ullnorse/ull-pocket/DATASHEETS.md

# Datasheets

Manufacturer datasheets are not stored in this repo. Download them from the links below. `datasheets/` is git-ignored for local copies.

| Ref | Part | LCSC | Datasheet |
|---|---|---|---|
| U1 | ESP32-C6-MINI-1-N4 module | C5736265 | [Espressif](https://www.espressif.com/sites/default/files/documentation/esp32-c6-mini-1_mini-1u_datasheet_en.pdf) |
| U1 | ESP32-C6 SoC | - | [Espressif](https://www.espressif.com/sites/default/files/documentation/esp32-c6_datasheet_en.pdf) |
| U2 | SHT40-AD1B | C2909890 | [Sensirion](https://sensirion.com/media/documents/33FD6951/67EB9032/HT_DS_Datasheet_SHT4x_5.pdf) |
| U3 | BMP580 | C22391138 | [Bosch](https://www.bosch-sensortec.com/media/boschsensortec/downloads/datasheets/bst-bmp580-ds004.pdf) |
| U4 | LIS2DW12TR | C189624 | [ST](https://www.st.com/resource/en/datasheet/lis2dw12.pdf) |
| U5 | MAX17048G+T10 | C2682616 | [Analog Devices](https://www.analog.com/media/en/technical-documentation/data-sheets/MAX17048-MAX17049.pdf) |
| U6 | BQ24073RGTR | C15220 | [TI](https://www.ti.com/lit/ds/symlink/bq24073.pdf) |
| U7 | RT9080-33GJ5 | C841192 | [Richtek](https://www.richtek.com/assets/product_file/RT9080/DS9080-05.pdf) |
| U8 | USBLC6-2SC6 (UMW) | C2687116 | [LCSC](https://www.lcsc.com/datasheet/C2687116.pdf) |
| J1 | TYPE-C-31-M-12 | C165948 | [LCSC](https://www.lcsc.com/datasheet/C165948.pdf) |
| J2 | 1.25-2PWB (PicoBlade series) | C2905009 | [LCSC](https://www.lcsc.com/datasheet/C2905009.pdf) |
| J3 | FPC-05FB-24PH20 | C2856831 | [LCSC](https://datasheet.lcsc.com/datasheet/pdf/e480b0871d0881a4ae70dd94a2979182.pdf?productCode=C2856831) (XUNPU drawing; page 1 shows pin 1 and the back-flip, dual-contact build) |
| Q1 | SI1308EDL | C469327 | [Vishay](https://www.vishay.com/docs/63399/si1308edl.pdf) |
| Q2 | AO3400A | C20917 | [LCSC](https://www.lcsc.com/datasheet/C20917.pdf) |
| D1, D5 | XL-1606 side-view LEDs | C965860, C965863 | [LCSC](https://www.lcsc.com/datasheet/C965863.pdf) |
| D6 | MHS110FRGBCT RGB side-view LED | C496820 | [LCSC](https://www.lcsc.com/datasheet/lcsc_datasheet_2006111804_MEIHUA-MHS110FRGBCT_C496820.pdf) |
| D2-D4 | MBR0530 | C82046 | [LCSC](https://www.lcsc.com/datasheet/C82046.pdf) |
| L1 | 47 uH, FNR40xxS | C167888 | [LCSC](https://www.lcsc.com/datasheet/C167888.pdf) |
| TH1 | NTC 10k B3950 0603 | C279936 | [LCSC](https://www.lcsc.com/datasheet/C279936.pdf) |
| SW1-SW3 | TS24CA | C393942 | [LCSC](https://www.lcsc.com/datasheet/C393942.pdf) |
| - | GDEY0154D67 e-paper panel (bought separately) | - | [Good Display](https://www.good-display.com/product/388.html) |
| - | SSD1681, controller inside the panel | - | [Adafruit copy](https://cdn-learn.adafruit.com/assets/assets/000/099/573/original/SSD1681.pdf) |
