ullnorse/ull-pocket/tools/archive/README.md

# Archived generators

`gen_sch.py` and `gen_lib.py` wrote `ull-pocket.kicad_sch` and `lib/ull-pocket.kicad_sym` from scratch up to rev 0.6. They are retired: the KiCad files are now the source and are edited in KiCad. Running these scripts would overwrite those edits.
