ullnorse/ull-pocket/docs/img/back.png

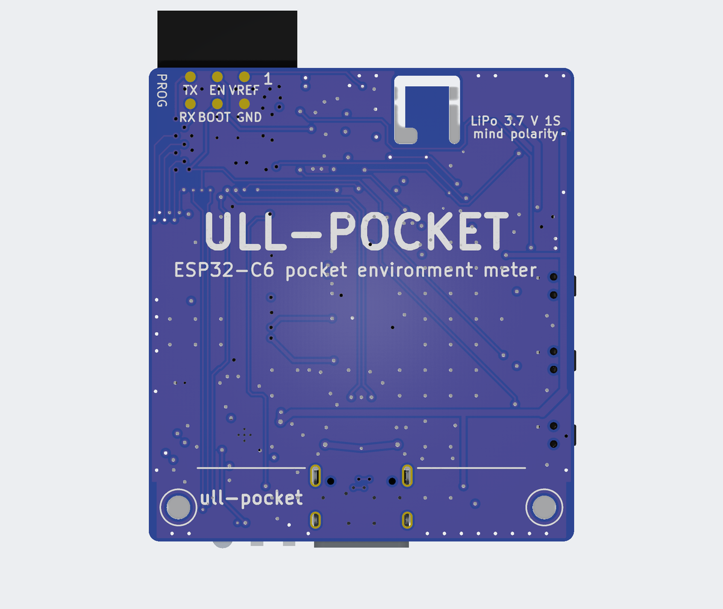
docs/img/back.png
