ullnorse/ull-pocket/PARTS.md

# ull-pocket parts, rev 0.9 (2026-11-09) (stock checked on JLCPCB via pcbparts.dev, 2026-10-28; LEDs 2026-10-29)

| Ref | Function | Part | LCSC | Package | Note |
|---|---|---|---|---|---|
| U1 | MCU + Wi-Fi/BLE/802.15.4 | ESP32-C6-MINI-1-N4 | C5736265 | 16.6x13.2 module, PCB antenna | 4 MB flash, -40..85 C (rev 0.7: was the 105 C -H4 C6553337, 569 in stock); antenna at board edge with keep-out |
| U2 | Temp / RH | SHT40-AD1B | C2909890 | DFN-4 1.5x1.5, P0.8 (`ull-pocket:Sensirion_DFN-4_1.5x1.5mm_P0.8mm_SHT4x`, 4 pads) | I2C 0x44; on the moated, thermally isolated island at the top edge, joined by thin bridge tracks; C11 decoupling sits on the island; the centre pad is not used (Sensirion allows it floating). Replaces SHT31-DIS-B2.5kS C80862 (rev 0.8) |
| U3 | Pressure | BMP580 | C22391138 | LGA-10 2x2, P0.5 (`ull-pocket:Bosch_LGA-10_2x2mm_P0.5mm_BMP580`) | I2C 0x46 (SDO to GND), CSB to +3V3 for I2C mode. Replaces BMP585 C18184976 (rev 0.8); the BMP585 mask-opening/keepout rule area is gone. INT resets active-low, open-drain, disabled (INT_CONFIG 0x14 = 0x35, datasheet p.53); R35 100k pulls BARO_INT high. Keep it open-drain, active-low in firmware |
| U4 | Accelerometer | LIS2DW12TR | C189624 | LGA-12 2x2, P0.5 (stock `Package_LGA:LGA-12_2x2mm_P0.5mm`) | I2C 0x19 (SA0 and CS to +3V3); INT1 to ACC_INT1 (LP GPIO) for wake. INT1 is push-pull active-high by default: set CTRL3 H_LACTIVE for active-low. Replaces LIS3DHTR C15134 (rev 0.8) |
| U5 | Fuel gauge | MAX17048G+T10 | C2682616 | DFN-8 2x2 | |
| U6 | Li-ion charger, power path | BQ24073RGTR | C15220 | VQFN-16 3x3, EP 1.68 (stock `VQFN-16-1EP_3x3mm_P0.5mm_EP1.68x1.68mm`) | 4.4 V OUT regulation; replaces BQ24074 (17 in stock). /CE (pin 4) on CHG_DIS from IO15 (rev 0.9; was GND): high pauses charging, OUT and battery supplement keep working (datasheet p.8); VIH 1.4 V, VIL 0.4 V (p.14) |
| U7 | 3.3 V LDO, ~2 uA Iq, 600 mA | RT9080-33GJ5 | C841192 | TSOT-23-5 | |
| C2 | U6 IN cap | CL10A105KB8NNNC 1uF/50V X5R | C15849 | 0603 | was 1uF/25V 0402 (C52923); 50 V rating for VBUS transients, basic part, 13M in stock |
| Q2 | Battery reverse-polarity FET (low side, BAT- lead) | AO3400A | C20917 | SOT-23 | basic part, 1.13M in stock; Vgs(max) 12 V; drain = BAT_N (J2 pin 1), source = GND, gate = VBAT via R11 100k |
| R13 | Sleep-current link, LDO_OUT to +3V3 | 0603WAF0000T5E 0R | C21189 | 0603 | basic part, 21.6M in stock; replace with an ammeter to measure sleep current |
| TP1-TP5 | Test pads: VBUS, VSYS, GND, VBAT, +3V3 (TP6 SPARE_IO14 removed in rev 0.6: IO14 drives the user LED) | TestPoint_Pad_1.0x1.0mm | - | 1.0 mm pad | footprint only, excluded from BOM |
| J4 | PROG pogo pads: VREF, GND, EN, IO9/BOOT (net BTN3_N, shared with SW3 DN), TXD0, RXD0 | PogoPads_2x3_P2.54mm_D1.0 | - | 2x3 grid, 2.54 mm pitch, 1.0 mm round SMD pads | footprint only, excluded from BOM and placement; on B.Cu above the panel; mates with a 2x3 pogo fixture (no room for a header); pad 1 is VREF, a sense-only reference fed from +3V3 through R27 1k: the programmer cannot power the board. Power from USB or the battery while programming |
| R27 | J4.1 VREF series resistor, +3V3 to J4 pad 1 | 0402WGF1001TCE 1k | C11702 | 0402 | basic; on F left of U1 at (20.4, 2.7), via + B.Cu run to the pad; limits programmer back-feed to ~1 mA |
| R3 | USB-C shield to GND | 0402WGF0000TCE 0R | C17168 | 0402 | basic; plastic case, shield tied straight to GND (was 1M) |
| C1 | USB-C shield RC option | 0402B472K500NT 4.7nF/50V | C1538 | 0402 | DNP; excluded from BOM and placement; footprint kept for a metal-case RC option |
| R28 + C27 | SW1 (UP) series resistor (switch side BTN_SW) + BTN_N debounce cap to GND | 0402WGF1000TCE 100R / CL05B104KO5NNNC 100nF | C25076 / C1525 | 0402 | basic; right of SW1; R28 limits ESD current into IO2; press discharges C27 in ~10 us through R28, release recharges it through R14 100k (tau 10 ms) |
| C7 | U7 output | CL05A106MQ5NUNC 10uF/6.3V X5R | C15525 | 0402 | basic; RT9080 needs 1 uF effective on its own while R13 is swapped for an ammeter |
| R9 | U6 ISET, charge current | 0402WGF3301TCE 3.3k 1% | C25890 | 0402 | 890/3.3k = 270 mA (241 mA min); chosen for low heat |
| R34 | U6 TMR, safety timer | 0402WGF6802TCE 68k 1% | C36871 | 0402 | 10 x KTMR x 68k = 6.8-11.3 h fast charge, 41-68 min pre-charge; outlasts a full 270 mA charge |
| C8 | U1 3V3 bulk | CL21A226MAQNNNE 22uF/25V X5R | C45783 | 0805 | basic, 4.05M in stock |
| C3, C4 | U6 OUT (VSYS) and BAT caps | CL21A106KAYNNNE 10uF/25V X5R | C15850 | 0805 | basic, 8.7M in stock (2026-11-09); was 10uF/10V 0603 until rev 0.9: the 0805 keeps more capacitance at 4.2-4.4 V bias. The 16 V C1713 is an extended part, so not used |
| C19 | E-paper boost coupling cap | CL21A475KBQNNNE 4.7uF/50V X5R | C98192 | 0805 | extended, 366k in stock |
| R25, R26 | 100k pull-ups to +3V3 on EPD_RST_N, EPD_CS_N (panel idle in sleep) | 0402WGF1003TCE | C25741 | 0402 | basic |
| R35 | 100k pull-up to +3V3 on BARO_INT (IO4), for the BMP580's open-drain INT | 0402WGF1003TCE | C25741 | 0402 | basic; IO4 is the MTMS strap, which only picks the SDIO sampling edge, so a pull-up is harmless (ESP32-C6 datasheet Table 3-1, p.33) |
| R36 | 100k pull-down to GND on CHG_DIS (IO15 to U6 /CE) | 0402WGF1003TCE | C25741 | 0402 | basic; under U6 pin 4. Keeps charging on through reset and whenever IO15 is an input: IO15 resets as input with no pull (ESP32-C6 datasheet Table 2-1, p.17). As a JTAG-source strap it reads 0, which only matters if EFUSE_JTAG_SEL_ENABLE is burned (Table 3-7, p.36). IO15 high draws ~45 uA: R36 plus /CE's own ~285k pull-down (BQ24073 datasheet p.8) |
| R24 | IO9 (BOOT strap) 10k pull-up to +3V3; also the SW3 (DN) pull-up, net BTN3_N | 0402WGF1002TCE | C25744 | 0402 | basic |
| U8 | USB ESD | USBLC6-2SC6 | C2687116 | SOT-23-6 | pin 5 (VBUS rail of the diode array) on +3V3, not VBUS (rev 0.9): the D+ pull-up can't back-feed VBUS through the upper diode on battery. D+/D- stay below 3.6 V, under 3.3 V + Vf, so the diodes stay off in normal use. VBUS keeps C2 1uF/50V; the BQ24073 IN is rated to 28 V |
| J1 | USB-C | TYPE-C-31-M-12 | C165948 | 16-pin SMD | 5.1k CC pull-downs |
| J2 | Battery | 1.25-2PWB (DEALON) | C2905009 | 1.25 mm 2P SMD, right angle | extended; 174k in stock, $0.03; JLC series PicoBlade (MX 1.25), 1 A, 3.6 mm tall, -25..+85 C. Footprint: Molex 53261 land, same pad layout as the DEALON drawing. Sized for the 103040 cell's "PH-1.25" plug; confirm that plug mates before ordering. Pin 2 = BAT+, pin 1 = BAT- (via Q2); confirm the cell's polarity with a multimeter. Mouth faces the left board edge, "-" above it, "+" below |
| J3 | E-paper FPC | FPC-05FB-24PH20 | C2856831 | 24P 0.5 mm, back flip, dual contact, H2.0 | panel tail wraps round the board edge so its fingers (display side) face away from the PCB; FPC-05F-24PH20 (C2856805) is bottom-contact and would mirror the pin order. Straight map: J3 pin n = panel pin n. See docs/mechanical.md |
| SW1, SW2, SW3 | Side buttons UP / OK / DN | TS24CA (side-actuated, right-angle SMD) | C393942 | 4.6x1.8 | left edge, 7.0 mm pitch (see docs/mechanical.md); SW1 UP on IO2 (BTN_N) and SW2 OK on IO5 (BTN2_N) wake from deep sleep, SW3 DN on IO9 (BTN3_N, rev 0.7; was IO15) is polled and doubles as BOOT; locating pegs are 0.7 mm NPTH holes (no pad) |
| R29, R30 + C28 | SW2 (OK) pull-up 100k to +3V3, series 100R (switch side BTN2_SW), BTN2_N debounce 100nF | 0402WGF1003TCE / 0402WGF1000TCE / CL05B104KO5NNNC | C25741 / C25076 / C1525 | 0402 | basic; same circuit as SW1 (R14/R28/C27) |
| R31 + C29 | SW3 (DN) series 100R (switch side BTN3_SW), BTN3_N debounce 100nF | 0402WGF1000TCE / CL05B104KO5NNNC | C25076 / C1525 | 0402 | basic; pull-up is R24 10k (IO9 strap): 10k x 100n = 1 ms, well inside the 10 ms EN delay, so IO9 reads high at reset unless DN is held |
| Q1 | E-paper boost switch | SI1308EDL-T1-GE3 | C469327 | SOT-323 | per panel reference circuit |
| D2-D4 | E-paper boost | MBR0530T1G | C82046 | SOD-123 | extended; kept per panel reference (B5819W basic considered, not worth deviating) |
| D1 + R6 | CHG indicator (red), side-view on bottom edge | XL-1606SURC (XINGLIGHT) | C965860 | SMD 1.7x1.1, 0.6 tall, side-view (lies flat, lens along the board) | extended; 221k in stock; Vf 1.9-2.3 V @20 mA, ~1.8 V @1 mA; from VSYS (4.4 V while charging) via R6 2k: (4.4-1.8)/2k = 1.3 mA, only while charging. R6 = 0402WGF2001TCE C4109 (basic); silkscreen CHG (D5 PWR, D6 USR) |
| D5 + R21 | Power LED (green), side-view on bottom edge, VBUS - 2k - LED - GND | XL-1606UGC (XINGLIGHT) | C965863 | SMD 1.7x1.1, 0.6 tall, side-view (lies flat, lens along the board) | extended; 238k in stock; InGaN emerald, Vf 2.6-3.4 V @20 mA, ~2.6 V @1 mA: (5.0-2.6)/2k = 1.2 mA, 0 on battery. R21 = 0402WGF2001TCE C4109 (basic) |
| D6 + R22, R32 | LED_USER, common anode to +3V3, side-view on bottom edge; a GPIO driven low turns its colour on. Red IO8 via R32 1k (~1.5 mA), blue IO14 via R22 470R (~1.5 mA); green unused (G pad unconnected, R33 removed in rev 0.9: IO15 became CHG_DIS); silkscreen USR | MHS110FRGBCT (MEIHUA) | C496820 | side-view RGB, footprint `ull-pocket:LED_MHS110FRGBCT_SideView`; dome 1.0 tall, overhangs the bottom edge ~0.7 mm | extended. R22 = 0402WGF4700TCE C25117 (basic); R32 = 0402WGF1001TCE C11702 (basic, same as R27). IO8 has the R16 pull-up, so red stays off at reset and the IO8 boot strap still reads high. Pinout per datasheet p.2: 1 anode, 2 B, 3 G, 4 R. Outer pads 0.7x0.8 per the datasheet land pattern (the EasyEDA footprint has 0.55). Replaces blue XL-1606UBC C965865 (rev 0.8) |
| TH1 | Battery NTC on BQ24073 TS | SDNT1608X103F3950FTF 10k 1% B3950 | C279936 | 0603 | extended; 59k in stock; place under/against the cell. Charge window 3.5..47.2 C nominal (75 uA bias: 28k / 4.0k trips; with INTC/VHOT/VCOLD tolerances 2.4-4.6 / 43.7-51.0 C); resume 6.5 / 44.7 C. Was B3435 (0.5..50.8 C) until the rev 0.7 review: most LiPo cells allow charging only to 45 C. A series resistor would raise the hot trip, a parallel one removes the cold trip. |
| R8 | TS fallback fixed 10k, parallel to TH1 | 0402WGF1002TCE | C25744 | 0402 | DNP; excluded from BOM and placement; fixed 10k = 25 C |
| L1 | E-paper boost | FNR4030S470MT 47 uH (limits: Isat 0.95 A, Irms 0.72 A, DCR 579 mR max; 20%) | C167888 | 4x4x3 mm shielded | extended; 82k in stock; replaces SWPA4018S470MT (Isat 570 mA); panel reference needs 47 uH / 500 mA; footprint + 3D from easyeda2kicad, pads 1,2 match L_Small |
| DISP | E-paper panel | Good Display GDEY0154D67 (SSD1681, 200x200) | — | — | not at LCSC; hand-fit after assembly |

LEDs D1 and D5 share footprint `ull-pocket:LED_XL-1606_SideView` (datasheet land pattern 2x 0.77x0.95 mm, pad 1 = cathode). The emitting face sits 0.1 mm inside the bottom board edge (pads 0.2 mm from the edge, custom DRC rule); D6 (RGB) uses its own footprint and overhangs the edge 0.65 mm. The case needs a window or light pipe at each LED.

Firmware GPIO notes (rev 0.9): ext1 deep-sleep wake mask is IO0-IO5 (BAT_ALRT_N, USB_PGOOD_N, BTN_N UP, ACC_INT1, BARO_INT, BTN2_N OK), all active-low once the LIS2DW12 polarity is set (CTRL3 H_LACTIVE); the BMP580 INT is active-low open-drain from reset, with R35 as its pull-up. BTN3_N (DN, IO9) is not an LP GPIO: poll it while awake. DN is also BOOT: held while the chip resets or powers up (unplug USB and battery, hold DN, plug USB in), it starts the ROM download mode for recovery flashing. Buttons read low when pressed. LED_USER is red and blue only, common anode, active-low: IO8 red, IO14 blue. IO15 is CHG_DIS, active-high: drive it high to pause charging (U6 /CE). R36 pulls it low, so charging stays on through reset and while IO15 is an input. IO15 is also a JTAG-source strap, read only when the JTAG-select eFuse is burned (default: don't care).

Firmware rules from the rev 0.7 review:
- Wake sources: USB_PGOOD_N (IO1) stays low while USB is plugged in, and BAT_ALRT_N (IO0) stays low until the MAX17048 alert is cleared. Wake on IO1 going high while USB is present (or leave it out of the mask), and clear the alert before sleeping, otherwise the chip wakes at once. Clearing it also stops 33 uA in R12.
- BARO_INT (IO4): leave the BMP580 INT open-drain, active-low (its reset setting) and enable it (INT_CONFIG int_en) before arming ext1. R35 holds the line high while it is off.
- Hold DC, SCK and MOSI (IO20/22/23) in deep sleep (gpio_hold_en + deep-sleep hold) so the powered SSD1681 inputs don't float.
- Never leave I2C (IO6/IO7) low in sleep: 330 uA per line. Run the bus at 100 kHz: the 10k pull-ups are too slow for 400 kHz.
- Battery: block Wi-Fi below about 3.55 V (MAX17048 reading) and set the gauge's voltage alert to put the chip into deep sleep; below that the LDO drops out during Wi-Fi bursts.
- CHG_DIS (IO15) in deep sleep: either hold it low (gpio_hold_en + deep-sleep hold) or leave it as an input with no pull, so R36 keeps charging on. Never leave it latched high unless charging should stay paused.
- Holding DN (IO9) at a power-up or brown-out reset starts the ROM download mode; deep-sleep wake is not affected.
