ullnorse/ull-pocket/production/ull-pocket-r0.9-bom.csv

Comment | Designator | Footprint | LCSC
1uF/50V | C2,C18,C20,C21,C22,C23,C24,C25,C26 | C_0603_1608Metric | C15849
10uF/25V | C3,C4 | C_0805_2012Metric | C15850
100nF/16V | C5,C9,C11,C12,C13,C14,C15,C27,C28,C29 | C_0402_1005Metric | C1525
1uF/25V | C6,C10 | C_0402_1005Metric | C52923
10uF/6.3V | C7 | C_0402_1005Metric | C15525
22uF/25V | C8 | C_0805_2012Metric | C45783
10uF/10V | C16 | C_0603_1608Metric | C19702
4.7uF/25V | C17 | C_0805_2012Metric | C1779
4.7uF/50V | C19 | C_0805_2012Metric | C98192
RED | D1 | LED_XL-1606_SideView | C965860
MBR0530 | D2,D3,D4 | D_SOD-123 | C82046
GREEN | D5 | LED_XL-1606_SideView | C965863
MHS110FRGBCT | D6 | LED_MHS110FRGBCT_SideView | C496820
TYPE-C-31-M-12 | J1 | USB_C_Receptacle_HRO_TYPE-C-31-M-12 | C165948
1.25-2PWB | J2 | Molex_PicoBlade_53261-0271_1x02-1MP_P1.25mm_Horizontal | C2905009
FPC-05FB-24PH20 | J3 | FPC-SMD_24P-P0.50_FPC-05FB-24PH20 | C2856831
47uH | L1 | IND-SMD_L4.0-W4.0_FNR40XXS | C167888
SI1308EDL | Q1 | SOT-323_SC-70 | C469327
AO3400A | Q2 | SOT-23 | C20917
5.1kR | R1,R2 | R_0402_1005Metric | C25905
0R | R3 | R_0402_1005Metric | C17168
100kR | R4,R5,R7,R11,R12,R14,R25,R26,R29,R35,R36 | R_0402_1005Metric | C25741
2kR | R6,R21 | R_0402_1005Metric | C4109
3.3kR | R9,R10 | R_0402_1005Metric | C25890
0R | R13 | R_0603_1608Metric | C21189
10kR | R15,R16,R17,R18,R24 | R_0402_1005Metric | C25744
1MR | R19 | R_0603_1608Metric | C22935
2.2R | R20 | R_0603_1608Metric | C22939
470R | R22 | R_0402_1005Metric | C25117
1kR | R27,R32 | R_0402_1005Metric | C11702
100R | R28,R30,R31 | R_0402_1005Metric | C25076
68kR | R34 | R_0402_1005Metric | C36871
TS24CA | SW1,SW2,SW3 | SW-SMD_2P-TS24CA | C393942
NTC10k | TH1 | R_0603_1608Metric | C279936
ESP32-C6-MINI-1-N4 | U1 | ESP32-C6-MINI-1 | C5736265
SHT40-AD1B | U2 | Sensirion_DFN-4_1.5x1.5mm_P0.8mm_SHT4x | C2909890
BMP580 | U3 | Bosch_LGA-10_2x2mm_P0.5mm_BMP580 | C22391138
LIS2DW12TR | U4 | LGA-12_2x2mm_P0.5mm | C189624
MAX17048G+T10 | U5 | TDFN-8_L2.0-W2.0-P0.50-BL-EP1.2 | C2682616
BQ24073RGTR | U6 | VQFN-16-1EP_3x3mm_P0.5mm_EP1.68x1.68mm | C15220
RT9080-33GJ5 | U7 | TSOT-23-5 | C841192
USBLC6-2SC6 | U8 | SOT-23-6 | C2687116
