ullnorse/ull-pocket/production/ull-pocket-r0.9-assembly.pdf

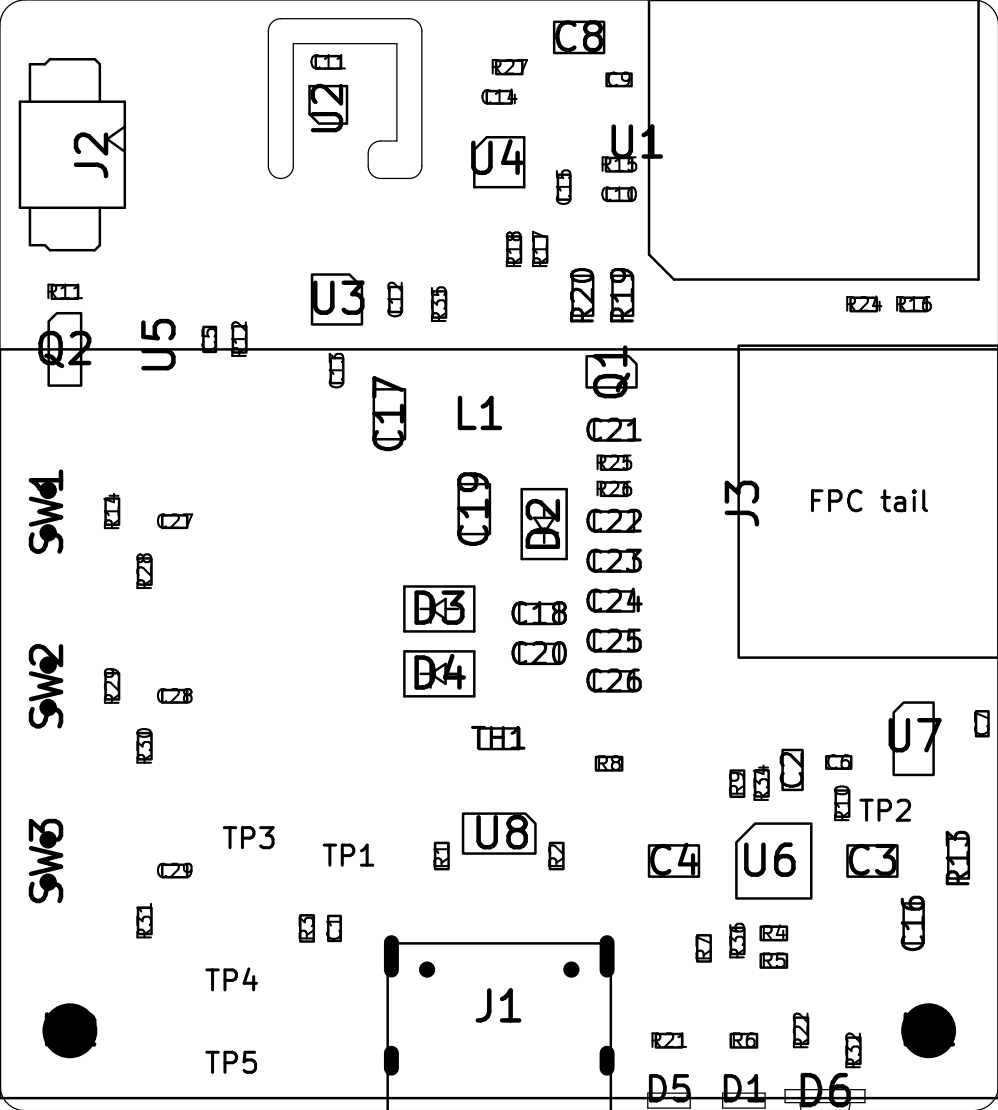
[picture p4: page 1]
