ullnorse/ull-pocket/ull-pocket.kicad_pcb

## KiCad design ull-pocket.kicad_pcb (2026-11-11)

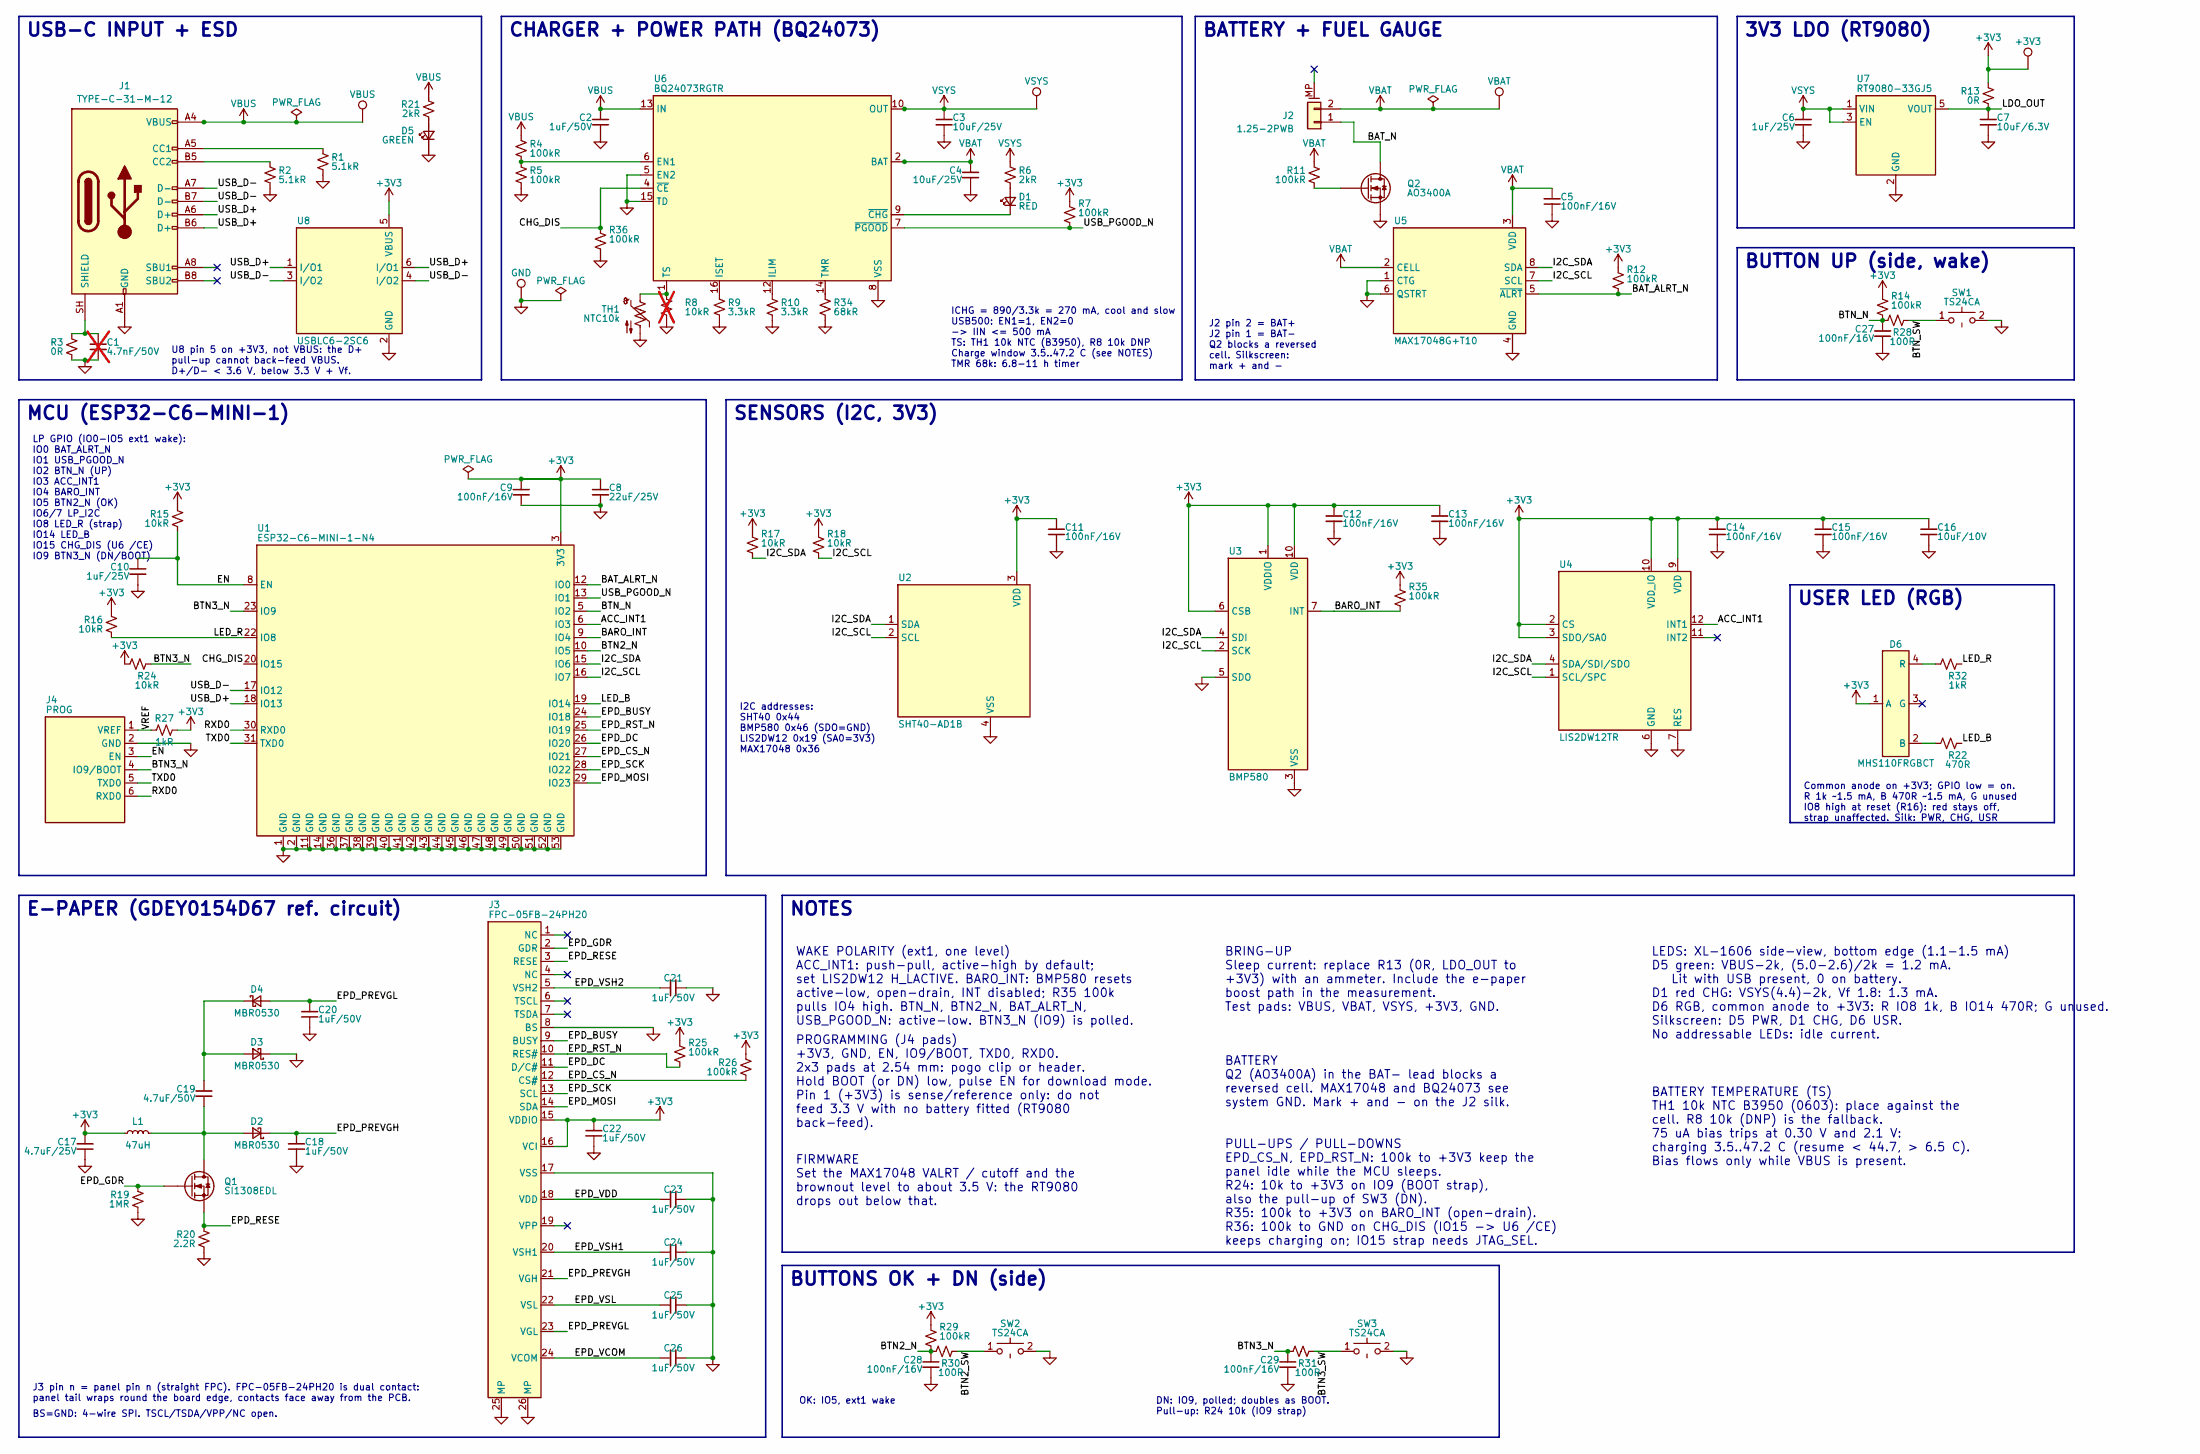
[picture p5: schematic ull-pocket.kicad_sch, ull-pocket: pocket environment meter]

Parts:
C1: 4.7nF/50V; C_0402_1005Metric; MPN 0402B472K500NT; LCSC C1538; not fitted
C2, C18, C20, C21, C22, C23, C24, C25, C26: 1uF/50V; C_0603_1608Metric; MPN CL10A105KB8NNNC; LCSC C15849
C3, C4: 10uF/25V; C_0805_2012Metric; MPN CL21A106KAYNNNE; LCSC C15850
C5, C9, C11, C12, C13, C14, C15, C27, C28, C29: 100nF/16V; C_0402_1005Metric; MPN CL05B104KO5NNNC; LCSC C1525
C6, C10: 1uF/25V; C_0402_1005Metric; MPN CL05A105KA5NQNC; LCSC C52923
C7: 10uF/6.3V; C_0402_1005Metric; MPN CL05A106MQ5NUNC; LCSC C15525
C8: 22uF/25V; C_0805_2012Metric; MPN CL21A226MAQNNNE; LCSC C45783
C16: 10uF/10V; C_0603_1608Metric; MPN CL10A106KP8NNNC; LCSC C19702
C17: 4.7uF/25V; C_0805_2012Metric; MPN CL21A475KAQNNNE; LCSC C1779
C19: 4.7uF/50V; C_0805_2012Metric; MPN CL21A475KBQNNNE; LCSC C98192
D1: RED; LED_XL-1606_SideView; MPN XL-1606SURC; LCSC C965860
D2, D3, D4: MBR0530; D_SOD-123; MPN MBR0530T1G; LCSC C82046
D5: GREEN; LED_XL-1606_SideView; MPN XL-1606UGC; LCSC C965863
D6: MHS110FRGBCT; LED_MHS110FRGBCT_SideView; MPN MHS110FRGBCT; LCSC C496820
J1: TYPE-C-31-M-12; USB_C_Receptacle_HRO_TYPE-C-31-M-12; MPN TYPE-C-31-M-12; LCSC C165948
J2: 1.25-2PWB; Molex_PicoBlade_53261-0271_1x02-1MP_P1.25mm_Horizontal; MPN 1.25-2PWB; LCSC C2905009
J3: FPC-05FB-24PH20; FPC-SMD_24P-P0.50_FPC-05FB-24PH20; MPN FPC-05FB-24PH20; LCSC C2856831
J4: PROG; PogoPads_2x3_P2.54mm_D1.0; MPN PROG
L1: 47uH; IND-SMD_L4.0-W4.0_FNR40XXS; MPN FNR4030S470MT; LCSC C167888
Q1: SI1308EDL; SOT-323_SC-70; MPN SI1308EDL-T1-GE3; LCSC C469327
Q2: AO3400A; SOT-23; MPN AO3400A; LCSC C20917
R1, R2: 5.1kR; R_0402_1005Metric; MPN 0402WGF5101TCE; LCSC C25905
R3: 0R; R_0402_1005Metric; MPN 0402WGF0000TCE; LCSC C17168
R4, R5, R7, R11, R12, R14, R25, R26, R29, R35, R36: 100kR; R_0402_1005Metric; MPN 0402WGF1003TCE; LCSC C25741
R6, R21: 2kR; R_0402_1005Metric; MPN 0402WGF2001TCE; LCSC C4109
R8: 10kR; R_0402_1005Metric; MPN 0402WGF1002TCE; LCSC C25744; not fitted
R9, R10: 3.3kR; R_0402_1005Metric; MPN 0402WGF3301TCE; LCSC C25890
R13: 0R; R_0603_1608Metric; MPN 0603WAF0000T5E; LCSC C21189
R15, R16, R17, R18, R24: 10kR; R_0402_1005Metric; MPN 0402WGF1002TCE; LCSC C25744
R19: 1MR; R_0603_1608Metric; MPN 0603WAF1004T5E; LCSC C22935
R20: 2.2R; R_0603_1608Metric; MPN 0603WAF220KT5E; LCSC C22939
R22: 470R; R_0402_1005Metric; MPN 0402WGF4700TCE; LCSC C25117
R27, R32: 1kR; R_0402_1005Metric; MPN 0402WGF1001TCE; LCSC C11702
R28, R30, R31: 100R; R_0402_1005Metric; MPN 0402WGF1000TCE; LCSC C25076
R34: 68kR; R_0402_1005Metric; MPN 0402WGF6802TCE; LCSC C36871
SW1, SW2, SW3: TS24CA; SW-SMD_2P-TS24CA; MPN TS24CA; LCSC C393942
TH1: NTC10k; R_0603_1608Metric; MPN SDNT1608X103F3950FTF; LCSC C279936
TP1: VBUS; TestPoint_Pad_1.0x1.0mm
TP2: VSYS; TestPoint_Pad_1.0x1.0mm
TP3: GND; TestPoint_Pad_1.0x1.0mm
TP4: VBAT; TestPoint_Pad_1.0x1.0mm
TP5: +3V3; TestPoint_Pad_1.0x1.0mm
U1: ESP32-C6-MINI-1-N4; ESP32-C6-MINI-1; MPN ESP32-C6-MINI-1-N4; LCSC C5736265
U2: SHT40-AD1B; Sensirion_DFN-4_1.5x1.5mm_P0.8mm_SHT4x; MPN SHT40-AD1B-R2; LCSC C2909890
U3: BMP580; Bosch_LGA-10_2x2mm_P0.5mm_BMP580; MPN BMP580; LCSC C22391138
U4: LIS2DW12TR; LGA-12_2x2mm_P0.5mm; MPN LIS2DW12TR; LCSC C189624
U5: MAX17048G+T10; TDFN-8_L2.0-W2.0-P0.50-BL-EP1.2; MPN MAX17048G+T10; LCSC C2682616
U6: BQ24073RGTR; VQFN-16-1EP_3x3mm_P0.5mm_EP1.68x1.68mm; MPN BQ24073RGTR; LCSC C15220
U7: RT9080-33GJ5; TSOT-23-5; MPN RT9080-33GJ5; LCSC C841192
U8: USBLC6-2SC6; SOT-23-6; MPN USBLC6-2SC6; LCSC C2687116

Connections:
+3V3: C8.1, C9.1, C11.1, C12.1, C13.1, C14.1, C15.1, C16.1, C17.1, C22.1, D6.1 (A), J3.15 (VDDIO), J3.16 (VCI), L1.1, R7.1, R12.1, R13.1, R14.1, R15.1, R16.1, R17.1, R18.1, R24.1, R25.1, R26.1, R27.2, R29.1, R35.1, TP5.1 (1_1), U1.3 (3V3), U2.3 (VDD), U3.1 (VDDIO), U3.6 (CSB), U3.10 (VDD), U4.2 (CS), U4.3 (SDO/SA0), U4.9 (VDD), U4.10 (VDD_IO), U8.5 (VBUS)
/ACC_INT1: U1.6 (IO3), U4.12 (INT1)
/BARO_INT: R35.2, U1.9 (IO4), U3.7 (INT)
/BAT_ALRT_N: R12.2, U1.12 (IO0), U5.5 (~ALRT)
/BAT_N: J2.1, Q2.3 (D)
/BTN2_N: C28.1, R29.2, R30.1, U1.10 (IO5)
/BTN2_SW: R30.2, SW2.1
/BTN3_N: C29.1, J4.4 (IO9/BOOT), R24.2, R31.1, U1.23 (IO9)
/BTN3_SW: R31.2, SW3.1
/BTN_N: C27.1, R14.2, R28.1, U1.5 (IO2)
/BTN_SW: R28.2, SW1.1
/CHG_DIS: R36.1, U1.20 (IO15), U6.4 (~CE)
/EN: C10.1, J4.3 (EN), R15.2, U1.8 (EN)
/EPD_BUSY: J3.9 (BUSY), U1.24 (IO18)
/EPD_CS_N: J3.12 (CS#), R26.2, U1.27 (IO21)
/EPD_DC: J3.11 (D/C#), U1.26 (IO20)
/EPD_GDR: J3.2 (GDR), Q1.1 (G), R19.1
/EPD_MOSI: J3.14 (SDA), U1.29 (IO23)
/EPD_PREVGH: C18.1, D2.1 (K), J3.21 (VGH)
/EPD_PREVGL: C20.1, D4.2 (A), J3.23 (VGL)
/EPD_RESE: J3.3 (RESE), Q1.2 (S), R20.1
/EPD_RST_N: J3.10 (RES#), R25.2, U1.25 (IO19)
/EPD_SCK: J3.13 (SCL), U1.28 (IO22)
/EPD_VCOM: C26.1, J3.24 (VCOM)
/EPD_VDD: C23.1, J3.18 (VDD)
/EPD_VSH1: C24.1, J3.20 (VSH1)
/EPD_VSH2: C21.1, J3.5 (VSH2)
/EPD_VSL: C25.1, J3.22 (VSL)
/I2C_SCL: R18.2, U1.16 (IO7), U2.2 (SCL), U3.2 (SCK), U4.1 (SCL/SPC), U5.7 (SCL)
/I2C_SDA: R17.2, U1.15 (IO6), U2.1 (SDA), U3.4 (SDI), U4.4 (SDA/SDI/SDO), U5.8 (SDA)
/LDO_OUT: C7.1, R13.2, U7.5 (VOUT)
/LED_B: R22.1, U1.19 (IO14)
/LED_R: R16.2, R32.1, U1.22 (IO8)
/RXD0: J4.6 (RXD0), U1.30 (RXD0)
/TXD0: J4.5 (TXD0), U1.31 (TXD0)
/USB_D+: J1.A6 (D+), J1.B6 (D+), U1.18 (IO13), U8.1 (I/O1), U8.6 (I/O1)
/USB_D-: J1.A7 (D-), J1.B7 (D-), U1.17 (IO12), U8.3 (I/O2), U8.4 (I/O2)
/USB_PGOOD_N: R7.2, U1.13 (IO1), U6.7 (~PGOOD)
/VREF: J4.1 (+3V3), R27.1
GND: C1.2, C2.2, C3.2, C4.2, C5.2, C6.2, C7.2, C8.2, C9.2, C10.2, C11.2, C12.2, C13.2, C14.2, C15.2, C16.2, C17.2, C18.2, C20.2, C21.2, C22.2, C23.2, C24.2, C25.2, C26.2, C27.2, C28.2, C29.2, D3.1 (K), D5.1 (K), J1.A1 (GND), J1.A12 (GND), J1.B1 (GND), J1.B12 (GND), J3.8 (BS), J3.17 (VSS), J3.25 (MP), J3.26 (MP), J4.2 (GND), Q2.2 (S), R1.2, R2.2, R3.2, R5.2, R8.2, R9.2, R10.2, R19.2, R20.2, R34.2, R36.2, SW1.2, SW2.2, SW3.2, TH1.2, TP3.1 (1_1), U1.1 (GND), U1.2 (GND), U1.11 (GND), U1.14 (GND), U1.36 (GND), U1.37 (GND), U1.38 (GND), U1.39 (GND), U1.40 (GND), U1.41 (GND), U1.42 (GND), U1.43 (GND), U1.44 (GND), U1.45 (GND), U1.46 (GND), U1.47 (GND), U1.48 (GND), U1.49 (GND), U1.50 (GND), U1.51 (GND), U1.52 (GND), U1.53 (GND), U2.4 (VSS), U3.3 (VSS), U3.5 (SDO), U3.8 (VSS), U3.9 (VSS), U4.6 (GND), U4.7 (RES), U4.8 (GND), U5.1 (CTG), U5.4 (GND), U5.6 (QSTRT), U5.9 (GND), U6.5 (EN2), U6.8 (VSS), U6.15 (TD), U6.17 (VSS), U7.2 (GND), U8.2 (GND)
unnamed: D1.2 (A), R6.2
unnamed: D1.1 (K), U6.9 (~CHG)
unnamed: C19.2, D2.2 (A), L1.2, Q1.3 (D)
unnamed: C19.1, D3.2 (A), D4.1 (K)
unnamed: D5.2 (A), R21.2
unnamed: D6.2 (B), R22.2
unnamed: D6.4 (R), R32.2
unnamed: J1.A5 (CC1), R1.1
unnamed: J1.B5 (CC2), R2.1
unnamed: C1.1, J1.SH (SHIELD), R3.1
unnamed: Q2.1 (G), R11.2
unnamed: R4.2, R5.1, U6.6 (EN1)
unnamed: R10.1, U6.12 (ILIM)
unnamed: R9.1, U6.16 (ISET)
unnamed: R34.1, U6.14 (TMR)
unnamed: R8.1, TH1.1, U6.1 (TS)
VBAT: C4.1, C5.1, J2.2, R11.1, TP4.1 (1_1), U5.2 (CELL), U5.3 (VDD), U6.2 (BAT), U6.3 (BAT)
VBUS: C2.1, J1.A4 (VBUS), J1.A9 (VBUS), J1.B4 (VBUS), J1.B9 (VBUS), R4.1, R21.1, TP1.1 (1_1), U6.13 (IN)
VSYS: C3.1, C6.1, R6.1, TP2.1 (1_1), U6.10 (OUT), U6.11 (OUT), U7.1 (VIN), U7.3 (EN)

Notes on the sheet:
BS=GND: 4-wire SPI. TSCL/TSDA/VPP/NC open.
PULL-UPS / PULL-DOWNS EPD_CS_N, EPD_RST_N: 100k to +3V3 keep the panel idle while the MCU sleeps. R24: 10k to +3V3 on IO9 (BOOT strap), also the pull-up of SW3 (DN). R35: 100k to +3V3 on BARO_INT (open-drain). R36: 100k to GND on CHG_DIS (IO15 -> U6 /CE) keeps charging on; IO15 strap needs JTAG_SEL.
BATTERY + FUEL GAUGE
NOTES
ICHG = 890/3.3k = 270 mA, cool and slow USB500: EN1=1, EN2=0 -> IIN <= 500 mA TS: TH1 10k NTC (B3950), R8 10k DNP Charge window 3.5..47.2 C (see NOTES) TMR 68k: 6.8-11 h timer
I2C addresses: SHT40 0x44 BMP580 0x46 (SDO=GND) LIS2DW12 0x19 (SA0=3V3) MAX17048 0x36
E-PAPER (GDEY0154D67 ref. circuit)
MCU (ESP32-C6-MINI-1)
USB-C INPUT + ESD
OK: IO5, ext1 wake
LEDS: XL-1606 side-view, bottom edge (1.1-1.5 mA) D5 green: VBUS-2k, (5.0-2.6)/2k = 1.2 mA. Lit with USB present, 0 on battery. D1 red CHG: VSYS(4.4)-2k, Vf 1.8: 1.3 mA. D6 RGB, common anode to +3V3: R IO8 1k, B IO14 470R; G unused. Silkscreen: D5 PWR, D1 CHG, D6 USR. No addressable LEDs: idle curr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
J2 pin 2 = BAT+ J2 pin 1 = BAT- Q2 blocks a reversed cell. Silkscreen: mark + and -
J3 pin n = panel pin n (straight FPC). FPC-05FB-24PH20 is dual contact: panel tail wraps round the board edge, contacts face away from the PCB.
SENSORS (I2C, 3V3)
CHARGER + POWER PATH (BQ24073)
WAKE POLARITY (ext1, one level) ACC_INT1: push-pull, active-high by default; set LIS2DW12 H_LACTIVE. BARO_INT: BMP580 resets active-low, open-drain, INT disabled; R35 100k pulls IO4 high. BTN_N, BTN2_N, BAT_ALRT_N, USB_PGOOD_N: active-low. BTN3_N (IO9) is polled.
USER LED (RGB)
DN: IO9, polled; doubles as BOOT. Pull-up: R24 10k (IO9 strap)
BUTTONS OK + DN (side)
PROGRAMMING (J4 pads) +3V3, GND, EN, IO9/BOOT, TXD0, RXD0. 2x3 pads at 2.54 mm: pogo clip or header. Hold BOOT (or DN) low, pulse EN for download mode. Pin 1 (+3V3) is sense/reference only: do not feed 3.3 V with no battery fitted (RT9080 back-feed).
BATTERY TEMPERATURE (TS) TH1 10k NTC B3950 (0603): place against the cell. R8 10k (DNP) is the fallback. 75 uA bias trips at 0.30 V and 2.1 V: charging 3.5..47.2 C (resume < 44.7, > 6.5 C). Bias flows only while VBUS is present.
BATTERY Q2 (AO3400A) in the BAT- lead blocks a reversed cell. MAX17048 and BQ24073 see system GND. Mark + and - on the J2 silk.
3V3 LDO (RT9080)
BUTTON UP (side, wake)
BRING-UP Sleep current: replace R13 (0R, LDO_OUT to +3V3) with an ammeter. Include the e-paper boost path in the measurement. Test pads: VBUS, VBAT, VSYS, +3V3, GND.
FIRMWARE Set the MAX17048 VALRT / cutoff and the brownout level to about 3.5 V: the RT9080 drops out below that.
LP GPIO (IO0-IO5 ext1 wake): IO0 BAT_ALRT_N IO1 USB_PGOOD_N IO2 BTN_N (UP) IO3 ACC_INT1 IO4 BARO_INT IO5 BTN2_N (OK) IO6/7 LP_I2C IO8 LED_R (strap) IO14 LED_B IO15 CHG_DIS (U6 /CE) IO9 BTN3_N (DN/BOOT)
Common anode on +3V3; GPIO low = on. R 1k ~1.5 mA, B 470R ~1.5 mA, G unused IO8 high at reset (R16): red stays off, strap unaffected. Silk: PWR, CHG, USR
U8 pin 5 on +3V3, not VBUS: the D+ pull-up cannot back-feed VBUS. D+/D- < 3.6 V, below 3.3 V + Vf.

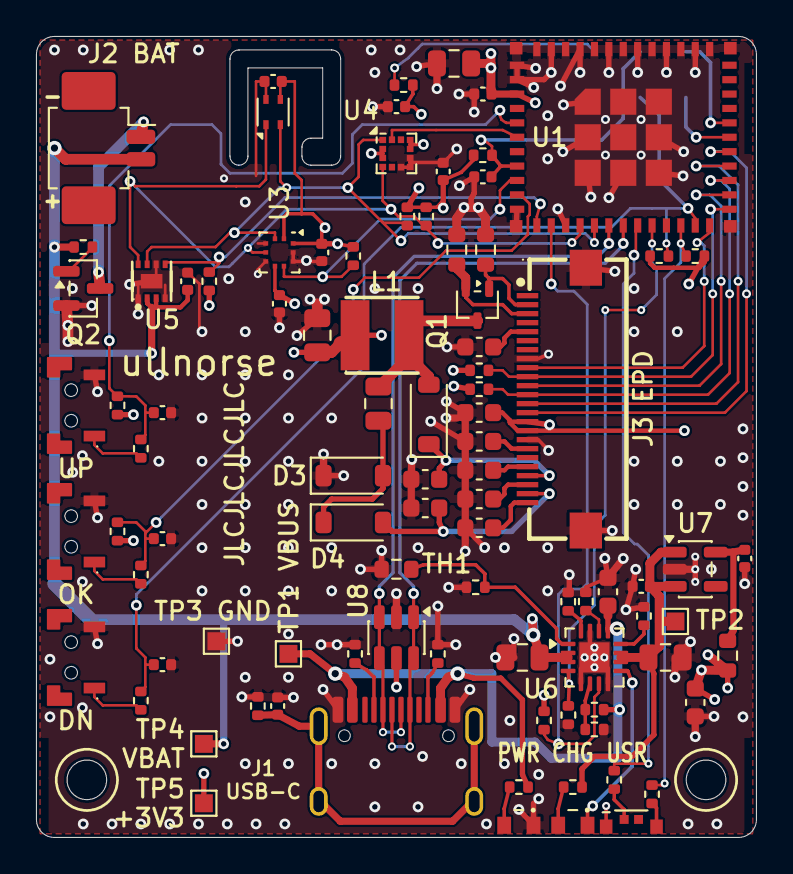
[picture p6: board ull-pocket.kicad_pcb from above]

Board: 4 copper layers, 40.0 x 44.5 mm, 97 parts (1 on the bottom side), 59 nets.

Other parts of the board:
ASSY1: ASSY_GDEY0154D67_Panel
ASSY2: ASSY_LiPo_103040
H1, H2: MountingHole_2.2mm_M2
