ullnorse/ull-pocket/(commit log)

2026-10-27 chore: start ull-pocket from American Embedded KiCad template
    [ull-pocket.kicad_pcb, ull-pocket.kicad_sch]
2026-10-27 feat(lib): add project symbol/footprint library and part datasheets
2026-10-27 feat(sch): full ull-pocket schematic with generator and netlist checks
    [template.kicad_sch, ull-pocket.kicad_sch]
2026-10-27 feat(sch): net-class colours, layout clean-up, 47uH boost inductor per panel reference
    [ull-pocket.kicad_sch]
2026-10-28 sch: reverse-polarity FET, BARO_INT on IO4, BMP585 pad 9 removed, test pads, 0R sleep link, net names, A3 layout cleanup (rev 0.2)
    [ull-pocket.kicad_sch]
2026-10-28 sch rev 0.3: power LED, two GPIO user LEDs (IO5, IO14), 47uH FNR4030 inductor, NTC on TS with DNP fallback
    [ull-pocket.kicad_sch]
2026-10-28 sch rev 0.4: PROG pogo cluster J4, EPD CS/RST pull-ups, IO15 pull-down, VQFN EP1.68 footprint, C8 22uF, C19 4.7uF/50V, orange/yellow 0603 user LEDs, BMP585 keepout shrunk, notes and layout clean-up
    [ull-pocket.kicad_sch]
2026-10-28 sch rev 0.5: single blue user LED (D6, IO5, 130R), IO14 spare test pad, BMP585 mask opening, IO15 pull-up, J4 note, R25 render fix
    [ull-pocket.kicad_sch]
2026-10-28 sch: R22 470R for blue LED (Vf at 1 mA is ~2.7-3.0 V, 130R would give ~5 mA)
    [ull-pocket.kicad_sch]
2026-10-29 layout phase 1: board setup and placement, J3 -> FPC-05FB-24PH20
    - 4-layer JLC stackup, design rules, net classes, outline with SHT31 tab
    - all 80 schematic parts placed (unrouted), GND zones defined, rule areas
    - panel on B side, FPC wrapped round right edge; J3 changed to dual-contact
    FPC-05FB-24PH20 (C2856831), straight pin map, schematic regenerated
    - assembly reference footprints/models for panel and LiPo; project 3D models
    - docs/mechanical.md
    [ull-pocket.kicad_pcb, ull-pocket.kicad_sch]
2026-10-29 layout phase 2: routed board, side-view LEDs
    - D1/D5/D6 -> XINGLIGHT XL-1606 side-view LEDs (C965860 red, C965863 green,
    C965865 blue) on the bottom edge; R6/R21 1.5k -> 2k (C4109), R22 stays 470R
    - new footprint/3D model LED_XL-1606_SideView; custom DRC rules (LED edge
    clearance 0.19, +-20 V rail clearance 0.2, SHT31 neck tracks <= 0.15)
    - placement tweaks for routing: boost Q1/R19/R20, J3 cap column, ESD U8,
    CC/EN/ILIM/TS resistors, pull-ups R17/R18/R25/R26/R7, TP1/TP2/TP6, C8/C10/C11/C16
    - full routing: USB pair 0.18/0.20 (~90 ohm) on B.Cu over In2 GND, boost loop
    on F, J3 decoupling fan-in, power on F/B/In2, In1 solid GND, In2 GND with a
    +3V3 pour (west) and VBUS/+3V3 traces, G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
    [ull-pocket.kicad_pcb, ull-pocket.kicad_sch]
2026-10-29 pcb: layout review round 1 fixes
    - Dog-bone vias out of fine-pitch and 0402 pads (U1, U3, U4, U5, C13,
    C14, R12, R15); via >= 0.25 mm from pad edge.
    - BMP585: F.Cu keepout +-1.75 mm, pins 7/8 joined outside the body,
    GND via moved out, no copper in the open window.
    - Thermal vias between paste windows (U6 project footprint with split
    paste, U1 EP vias at window gaps).
    - +3V3 to U1 via R13 vias into In2 plane, C8/C9 via pair; In2 VBAT link
    and B-side trunk removed; B.Cu signals no longer cross In2 splits.
    - J4 moved to the top strip by U1, R25/R26 beside J3, TP6 moved,
    B.Cu runs tidied; J1 mouth 0.6 mm past the bottom edge.
    - Extra GND vias at R20 and C18 for the boost loop.
    - EPD_B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
    [ull-pocket.kicad_pcb, ull-pocket.kicad_sch]
2026-10-29 pcb: layout review round 2 fixes
    - J4 (PROG) to B.Cu top-right under U1, above the panel: clear of the
    J2 plug and lead. TXD0/RXD0/BOOT/EN rerouted short. Pogo footprint
    courtyard is now pads + 0.15 mm and the header outline is gone.
    - Silk: stale PROG text removed, PROG label on J4, TP1-TP3 refs on silk,
    PWR/CHG/USR and TP4/TP5 separated.
    - U6 EP: four extra 0.45/0.2 vias in the paste cross; paste windows
    moved to +-0.51 to clear them; scoped hole-to-hole rule (0.3 mm).
    - VBAT: 0.8 mm J2 legs, 0.6 mm long runs, second via at J2 and at U6.
    - In2 GND corridor extended under the LED_USER lane.
    - LDO_OUT 0.4 mm (0.35 mm past U7.4/C7); zero-length segments and
    U7.2 GND fold-back remove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
    [ull-pocket.kicad_pcb]
2026-10-29 production: JLCPCB gerbers, drills, BOM, CPL and rotation check; J4 silk tweak; programming access doc
    [ull-pocket-r0.5-bom.csv, ull-pocket.kicad_pcb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]
2026-10-29 J2 to DEALON PH-2PWB, D2-D4 to basic B5819W, JLC order-number marker, regenerate production package
    [ull-pocket-r0.5-bom.csv, ull-pocket.kicad_pcb, ull-pocket.kicad_sch]
2026-10-30 Keep MBR0530 boost diodes per panel reference; regenerate production package
    [ull-pocket-r0.5-bom.csv, ull-pocket.kicad_pcb, ull-pocket.kicad_sch]
2026-10-30 Trim F.Silk outlines past board edge (SW1, J1, U1); regenerate gerbers
    [ull-pocket.kicad_pcb]
2026-10-30 Move SHT31 onto a moated island inside a plain 40 x 44.5 mm rectangle
    The top-left SHT31 tab and neck are gone; the outline is now a plain
    rectangle (R1 corners). U2 and C11 sit on a 4.15 x 3.9 mm island at the
    top edge (x 11.75-15.9, y 1.75-5.65), cut free by a 1.0 mm NPTH milled
    moat on three sides that wraps both bottom corners. A 3.0 x 1.5 mm bridge
    carries only SDA, GND, SCL and +3V3 (0.15 mm F.Cu). No pour on any layer
    over the rim, moat, island or bridge (SHT_island_no_pour; DRU rule renamed).
    BTN_N (B.Cu) detours under the moat. SDA rejoins the U5 riser and SCL
    drops onto the B.Cu bus with a new via. The old tab feeds are removed.
    C11 is rotated to 90 deg; U2 keeps its rotation.
    DR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
    [ull-pocket.kicad_pcb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]
2026-10-30 Silkscreen polish: visible refs, TP net labels, function labels, back title block
    F.Silk: references are 1.0 mm text with a 0.15 mm stroke, at 0 or 90 deg.
    They are placed beside their part, off pads, bodies, other silk, edges and
    the moat. 32 refs were placed by tools/route/silk_polish.py. Refs with no
    room stay on F.Fab: C10 C11 C18 C21-C25 D1 D2 D5 D6 R6 R10 R18-R21 R25 R26.
    Test points read "TPn NET", except TP2 and TP6 (no room). New labels:
    J1 USB-C, J3 EPD, SW1 WAKE, U2 RH/T, and J2 BAT replacing BAT.
    B.Silk: signal labels under each J4 pogo pad (3V3 EN TX / GND BOOT RX).
    Title block: ULL-POCKET, the board description and "rev 0.5 2026-10".
    "LiPo 3.7 V 1S / mind polarity" sits behi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
    [ull-pocket.kicad_pcb]
2026-10-31 Schematic review: shield to GND, sense-only J4 VREF, SW1 series R and debounce cap
    - USB-C shield: R3 goes from 1M to 0R (0402WGF0000TCE, C17168). C1 4.7 nF
    is DNP, excluded from BOM and CPL; its footprint stays. Copper unchanged.
    - J4 pad 1 is the new net VREF, fed from +3V3 through R27 1k
    (0402WGF1001TCE, C11702), so a programmer cannot power the board.
    R27 sits on F at (20.4, 2.7), left of U1. A via and a B.Cu run along the
    top edge reach the pad. The old +3V3 via under U1 is removed.
    J4 pin 1 is renamed VREF in the symbol.
    - SW1: R28 100R (0402WGF1000TCE, C25076) sits between the switch (BTN_SW)
    and BTN_N. C27 100 nF (C1525) goes from BTN_N to GND. Both are right of SW1.
    ERC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
    [ull-pocket-r0.5-bom.csv, ull-pocket.kicad_pcb, ull-pocket.kicad_sch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]
2026-11-01 Move to stock KiCad 10.0.8
    Convert board, schematic and project libraries from the Backplane KiCad fork
    format to KiCad 10.0 and point all scripts at the system kicad-cli.
    Custom DRC rule uses memberOfFootprint() (stock rejects A.Parent.Reference).
    gen_lib reads the stock single-file symbol libraries; jlc_cpl reads (at).
    Gerbers, BOM and CPL are unchanged.
    [ull-pocket.kicad_pcb, ull-pocket.kicad_sch]
2026-11-01 Schematic: draw all 22 ESP32 GND pins on a visible bus
    U1 symbol gets one visible pin per GND pad (1, 2, 11, 14, 36-53) instead of a
    hidden stack; MCU box widened, sensor box and its pull-ups shifted right.
    [ull-pocket.kicad_sch]
2026-11-01 Rev 0.6: three side buttons UP/OK/DN
    SW1 UP (IO2), SW2 OK (IO5) and SW3 DN (IO15) on the left edge at 7.0 mm pitch
    (y 20.5 / 27.5 / 34.5). SW2 copies the SW1 circuit (R29 100k, R30 100R, C28
    100nF); SW3 uses the R24 10k IO15 strap as its pull-up (R31 100R, C29 100nF).
    LED_USER moves from IO5 to IO14; SPARE_IO14 and TP6 are gone, and IO15 reuses
    the old IO14 B.Cu run. TP4/TP5 move below the DN button. The UP/OK/DN silk
    labels are board texts, and the TS24CA library footprint drops its unused
    silk lines, so all three switches match the library. Board edits are in
    tools/route/rev06_buttons.py.
    [ull-pocket-r0.5-bom.csv, ull-pocket.kicad_pcb, ull-pocket.kicad_sch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]
2026-11-01 Production files r0.6
    [ull-pocket-r0.6-bom.csv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]
2026-11-01 J4 back silk: label pad 1 VREF
    [ull-pocket.kicad_pcb]
2026-11-01 Add README with renders and schematic
2026-11-01 README: KiCad setup, opening and editing instructions
2026-11-01 Retire schematic and symbol generators; KiCad files are now the source
    gen_sch.py, gen_lib.py and the template move to tools/archive/. build_sch.sh is
    replaced by check_sch.sh (ERC, netlist, check_net, check_pins, PDF/PNG) which
    does not rewrite the schematic.
    [template.kicad_sch]
2026-11-01 Chamfer 48 right-angle track corners to 45 degrees; regenerate Gerbers
    [ull-pocket.kicad_pcb]
2026-11-01 Rev 0.7: DN button moves to IO9 and doubles as BOOT; README programming section
    [ull-pocket-r0.7-bom.csv, ull-pocket.kicad_pcb, ull-pocket.kicad_sch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]
2026-11-01 3D models checked against datasheets: fix J1/J3/SW/U2 placement, L1/U6/U8/TH1 heights, XL-1606 LED lying flat; docs
    [ull-pocket.kicad_pcb]
2026-11-01 Review fixes: switch shell tabs unconnected, no vias in SW3 pads, U3 per-pad mask, U5 EP paste 60%, U7 GND solid, silk strokes; ordering steps and firmware rules
    [ull-pocket.kicad_pcb, ull-pocket.kicad_sch]
2026-11-01 J2 turned to the left edge and re-routed; ESP32-C6-MINI-1-N4; TH1 B3950 NTC (3.5-47 C charge window); assembly panel with left/right rails (tools/panelize.sh); restore BMP585 mask opening (datasheet 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
    [ull-pocket-r0.7-bom.csv, ull-pocket-r0.7-panel-bom.csv, ull-pocket.kicad_pcb, ull-pocket.kicad_sch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]
2026-11-01 kicad_pro: KiCad 10 default schematic settings
2026-11-03 Silkscreen and DFM pass against a best-practices checklist
    - schematic notes updated to rev 0.7 (DN on IO9, B3950 NTC window)
    - DRC rules for JLC silk spacing; fixed the four violations
    - resistor/capacitor refdes hidden; assembly drawing lists every part
    - silk stroke 1/6 of height, button labels 1.0 mm
    - no-pour areas behind panel tabs: mouse bites no longer cut the pours
    - docs/best-practices.md: checklist with sources and this board's status
    [ull-pocket.kicad_pcb, ull-pocket.kicad_sch]
2026-11-03 Rev 0.8: SHT40, BMP580, LIS2DW12, RGB user LED
    - U2 SHT31 -> SHT40-AD1B (DFN-4 1.5x1.5) on the moated island
    - U3 BMP585 -> BMP580 (LGA-10 2x2), U4 LIS3DH -> LIS2DW12 (LGA-12 2x2); sensor cluster re-routed
    - D6 -> MHS110FRGBCT common-anode side-view RGB: R IO8/R32 1k, G IO15/R33 1k, B IO14/R22 470R, active-low
    - GND_F islands under the SHT40 and BMP580 tied to GND; LED labels moved clear of R22
    - r0.8 production files (board + panel), assembly PDF, renders, docs
    - tools/rev08: scripts that made the changes
    [ull-pocket-r0.8-bom.csv, ull-pocket-r0.8-panel-bom.csv, ull-pocket.kicad_pcb, ull-pocket.kicad_sch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]
2026-11-03 D6: outer pads 0.7 mm wide per the MHS110FRGBCT land pattern; pinout checked against the datasheet
    [ull-pocket.kicad_pcb]
2026-11-03 Docs: verified SHT40 height, 3D model sizes, RGB overhang 0.65 mm, TS24CA side-actuated
2026-11-03 Silk cleanup: hole rings, back chin mark, rev 0.8 text
    Rings round the M2 holes on both sides (H1/H2 refs hidden). Back chin under the
    display: frame line split round the USB-C legs, ull-pocket and rev 0.8. Back
    rev text 0.7 -> 0.8. Production files and README renders regenerated.
    [ull-pocket.kicad_pcb]
2026-11-03 Blue solder mask in stackup; renders use stackup colours
    [ull-pocket.kicad_pcb]
2026-11-03 Silk: drop revision and date texts
    [ull-pocket.kicad_pcb]
2026-11-03 Case draft 1: front shell, snap-on back cover, button plungers; mesh fit check and renders
2026-11-06 Fit board and case to the 103040 cell: 1.25 mm J2, 405 mA charge, 20.9 mm case
    J2 is now DEALON 1.25-2PWB (C2905009) on the Molex 53261 land, moved and rerouted around I2C_SDA.
    R9 is 2.2k: 270 mA could outlast the charger's 4-6 h safety timer on 1200 mAh.
    [ull-pocket-r0.8-bom.csv, ull-pocket-r0.8-panel-bom.csv, ull-pocket.kicad_pcb, ull-pocket.kicad_sch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]
2026-11-06 Review rounds: C7 10 uF, J1 CPL on shell legs, cell stops and button travel in case, docs
    Verified findings from three review rounds. C7 meets the RT9080 minimum without the +3V3 bank.
    J1 placement aligns pegs with their holes. Case stops the cell sliding; plunger gap and snaps enlarged.
    README adds Standard PCBA, firmware rules and a first-board charge test.
    [ull-pocket-r0.8-bom.csv, ull-pocket-r0.8-panel-bom.csv, ull-pocket.kicad_pcb, ull-pocket.kicad_sch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]
2026-11-06 Charge at 270 mA to cut heat; R34 68k sets a timer that outlasts a full charge
    R9 back to 3.3k. U6 dissipates about 0.35 W instead of 0.53 W at 3.7 V.
    VBUS drops to F.Cu beside U6 pin 13, freeing room for R34 at pin 14.
    [ull-pocket-r0.8-bom.csv, ull-pocket-r0.8-panel-bom.csv, ull-pocket.kicad_pcb, ull-pocket.kicad_sch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]
2026-11-06 README: keep the CHG timer fault note
2026-11-06 Renders: true part colours, no vendor logos, neutral background
    Recolours the vendor 3D models and removes their EasyEDA logos without
    changing geometry. Gerbers, BOM and CPL are untouched.
2026-11-06 Add docs/learn.html, an interactive course on every part of the board
2026-11-06 Replace unconfirmed claims in the course with datasheet facts
    U8 diode topology from its datasheet diagram, RT9080 VOUT-to-VIN limit,
    SSD1681 voltage ranges, Espressif USB checklist wording. List SSD1681.
2026-11-06 Make course copy button work over plain http
    Browsers hide the clipboard API on http LAN addresses, so fall back to
    execCommand. Add an empty icon to stop the favicon 404.
2026-11-06 Make the course self-contained for phone reading
    Embed the real schematic with a zoomable viewer and tappable parts, pin and
    net lists for every part, the four copper layers with net highlighting, and
    datasheet excerpts. Replace exercises that needed KiCad or the PDFs. Explain
    Vf and draw U8's diodes.
2026-11-09 Rev 0.9: BMP580 INT pull-up, U8 on +3V3, VBUS on B.Cu, 0805 charger caps
    - BMP580 INT resets active-low, open-drain and disabled (datasheet p.53);
    fix the schematic note and add R35 100k pull-up on BARO_INT.
    - U8 pin 5 moves from VBUS to +3V3, so the D+ pull-up can't back-feed
    VBUS on battery; drop the TP1 leak firmware rule.
    - VBUS from J1 to U6 IN moves off In2 to B.Cu at 0.5 mm; the C2 stub to
    pin 13 widens to 0.5 mm where pin 14 allows.
    - Two more GND vias under U7 pin 2.
    - C3/C4: 10 uF 25 V X5R 0805 (C15850, basic; C1713 is extended).
    - J2 +/- marks at the connector mouth; three back-silk texts removed.
    - J3 checked against the XUNPU drawing; BMP580 land checked; no change.
    - Prod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
    [ull-pocket-r0.9-bom.csv, ull-pocket-r0.9-panel-bom.csv, ull-pocket.kicad_pcb, ull-pocket.kicad_sch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]
2026-11-09 Give BQ24073 /CE a GPIO: IO15 drives CHG_DIS, USR LED red/blue
    - IO15 leaves D6's green channel and drives U6 /CE as CHG_DIS
    (active-high: high pauses charging, OUT keeps running; BQ24073 p.8).
    - R36 100k 0402 (C25741) pulls CHG_DIS to GND next to U6, so charging
    stays on through reset and sleep. IO15 resets as an input with no
    pull (ESP32-C6 datasheet Table 2-1 p.17); its JTAG strap is read only
    with EFUSE_JTAG_SEL_ENABLE burned (Table 3-7 p.36).
    - R33 removed; D6 G pad left unconnected (no-connect in the schematic).
    - Route: B.Cu from IO15, F.Cu hop over LED_B at y 115.2, B.Cu down the
    PGOOD/LED_B channel to a via beside U6 pin 4.
    - Firmware rule: in deep sleep hold IO15 low or l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
    [ull-pocket-r0.9-bom.csv, ull-pocket-r0.9-panel-bom.csv, ull-pocket.kicad_pcb, ull-pocket.kicad_sch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]
2026-11-09 README: first-board power-up steps with the panel continuity check
2026-11-11 Silk: ullnorse wordmark on the front, ullnorse replaces ull-pocket on the back
    [ull-pocket.kicad_pcb]
